kratzsci/ProfessorXY/References/Transmission.md

# Transmission from ESP32 to Arduino
<<<<<<< HEAD
Remaining Characters:
I, J, K, O, Q, V, W, Y, Zero (0)

| **Character** | **Controller Command** |
| :---: | :---: |
| **Menu buttons** |
| `A` | Start |
| `B` | Select |
| `Z` | PS |
| **Shape buttons** |
| `T` | Triangle |
| `X` | Cross |
| `S` | Square |
| `C` | Circle |
| **Directional buttons** |
| `L` | Left |
| `R` | Right |
| `U` | Up |
| `D` | Down |
| **Bumpers** |
| `E` | Left Bumper |
| `F` | Right Bumper |
| **Triggers** |
| `G` | Left Trigger |
| `H` | Right Trigger |
| **Analog sticks** |
| `1` | Forward |
| `2` | Backward |
| `3` | Right |
| `4` | Left |
| `5` | Forward Left |
| `6` | Forward Right |
| `7` | Backward Left |
| `8` | Backward Right |

# Robot commands

| **Character** | **Robot Command** | **Button** |
| :---: | :---: | :---: |
| **Mode** |
| `A` | Limb mode | Start |
| `B` | Simple drive mode | Select |
| `Z` | Demo mode | PS |
| **Head** |
| `U` | Head Up | Up |
| `D` | Head Down | Down |
| **Neck** |
| `L` | Neck Left | Left |
| `R` | Neck Right | Right |
| **Shape buttons** |
| `T` | Left elbow up | Triangle |
| `X` | Left elbow down | Cross |
| `S` | Right elbow up | Square |
| `C` | Right elbow down | Circle |
| **Bumper/Trigger** |
| `E` | Left shoulder up | Left Bumper |
| `F` | Left shoulder down | Right Bumper |
| `G` | Right shoulder up | Left Trigger |
| `H` | Right shoulder down | Right Trigger |
| **Analog sticks** |
| `1` | Forward |
| `2` | Backward |
| `3` | Right |
| `4` | Left |
| `5` | Forward Left |
| `6` | Forward Right |
| `7` | Backward Left |
| `8` | Backward Right |
=======

# Robot commands
| **Buttons** | **Robot Command** | **Character transmitted** |
| :---: | :---: | :---: |
| ----- | ----- | ------ |
| **UNBOUND** | ----- | ----- |
| Start | UNBOUND | `A` |
| Select | UNBOUND | `B` |
| PS | UNBOUND | `Z` |
| Touch Pad | UNBOUND | `Y` |
| ----- | ----- | ------ |
| **Directional Buttons** | ----- | ----- |
| Up | Head up | `U` |
| Left | Neck left | `L` |
| Right | Neck right | `R` |
| Down | Head down | `D` |
| ----- | ----- | ------ |
| **Shape buttons** | ----- | ----- |
| Triangle | Left elbow up | `T` |
| Square | Right elbow up | `S` |
| Circle | Left elbow down | `C` |
| Cross | Right elbow down | `X` |
| ----- | ----- | ------ |
| **Bumper/Trigger** | ----- | ----- |
| Left Bumper | Left shoulder up | `E` |
| Left Trigger | Left shoulder down | `F` |
| Right Bumper | Right shoulder up | `G` |
| Right Trigger | Right shoulder down | `H` |
| ----- | ----- | ------ |
| **Stop all** | ----- | ----- |
| Left Analog sticks center | Stop all | `0` |
| ----- | ----- | ------ |
| **Left Analog sticks** | ----- | ----- |
| ----- | Forward | `1` |
| ----- | Backward | `2` |
| ----- | Right | `3` |
| ----- | Left | `4` |
| ----- | ----- | ------ |
| **Stop all** | ----- | ----- |
| Left Analog sticks center | Stop all | `0` |
>>>>>>> main
