kratzsci/ProfessorXY/Master_s Project Presentation - Philipp _ Johnathan.pptx

## Professor X~~&Y~~ re-work

Philipp Kratsch & Johnathan Hager

## Objective

- Re-work humanoid robot~~s~~
  - Previously worked on by other graduate students
- Two 12V car batteries replace with one 12v
- Robot motors two 24V replace with 12v, if battery change
- Bundle and Clean up wiring

## Objective

- Document the re-design
  - Documentation in progress
- Tighten mechanical parts
- Addition of other work
  - Other work was a complete mess
  - Spent several days trying to sort through

## Problems

- Previous problems we found with the parts
  - One of the arduino megas
  - Four Pololu motor control boards (For the actuators)
  - Roboclaw board (Driving motor control boards)
  - LEDs eyes
  - Servo eyebrows

## Problems

- Previous problems we found with the design
  - Overly complex
  - Nothing seemed to be working together, if at all

## Re-design

- Battery
  - Two 12v to One 12v car battery
- Motors
  - Changed from 24v to 12v
- Charging
  - Extension cord

## Re-design

- Physical switch to control
  - On, Off, and charging mode
- Tighten mechanical parts
  - Straighten up the body
  - Fixed misaligned wheels
  - Checked every joint

## Re-design

- Bundle all wires
  - Removed all previous wiring (it was a mess)
  - Rewired everything for a cleaner look
- Bluetooth control
  - Old usb dongle and hat (Worked intermittently)
  - New ESP32

## Components

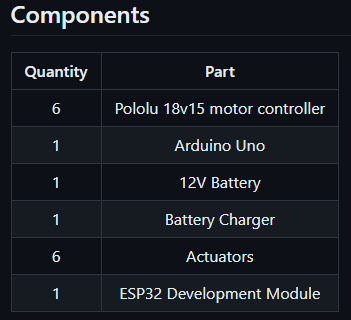
[picture p2: figure]

## Wiring Diagram

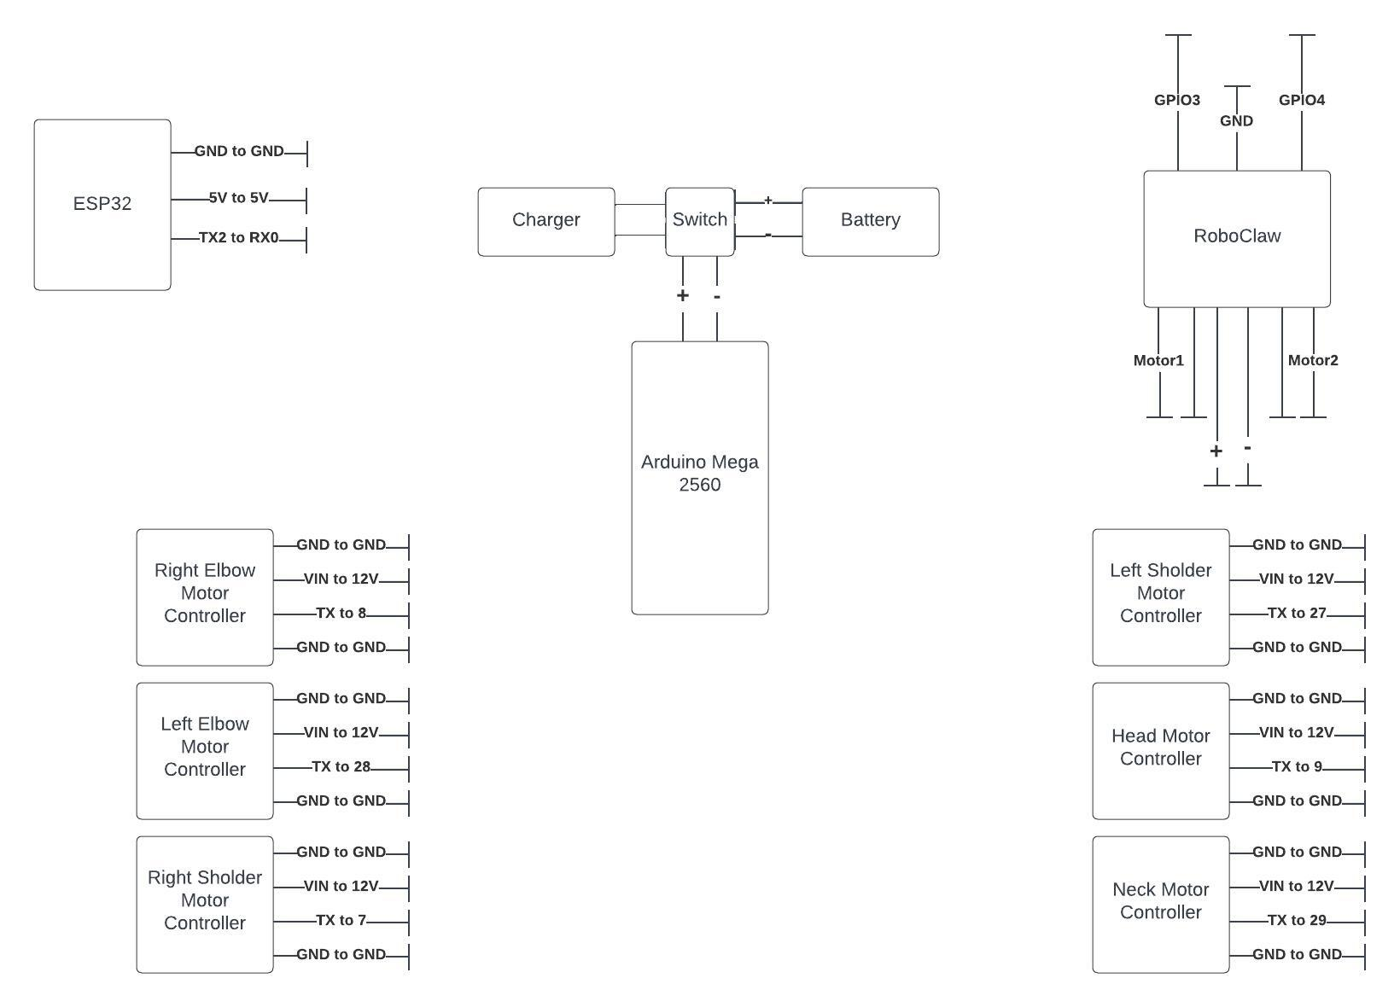
[picture p3: figure]

## ESP32 - Controller

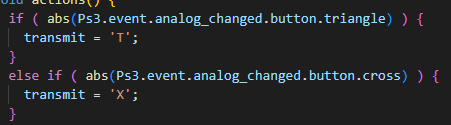
[picture p4: figure]
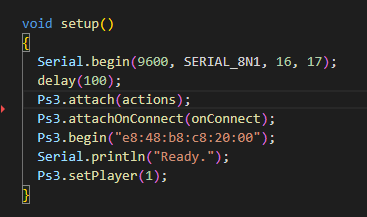
[picture p5: figure]

## Arduino - Robot

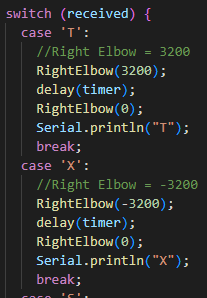
[picture p6: figure]
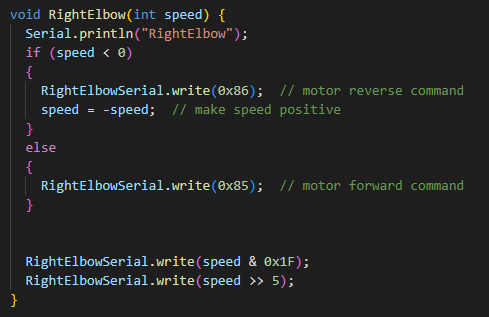
[picture p7: figure]

## Demo

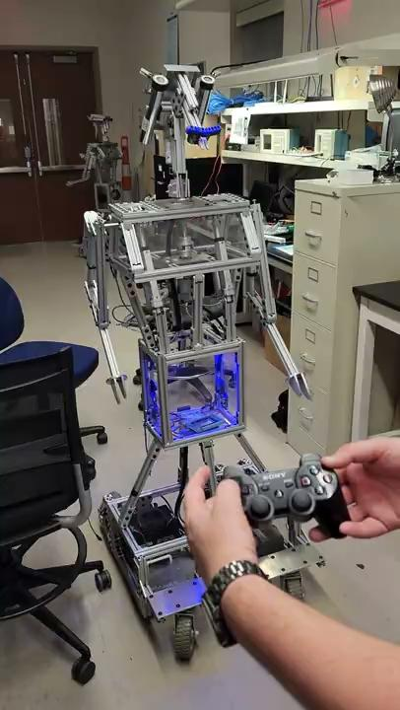
[picture p8: figure]

- Video
- Live

## Recommend future work

- Mechanically reworked
  - Less of a rigid design
  - Remove excess weight
- Additions
  - New LEDs for the eyes
  - New servos for the eyebrows
  - Speakers
  - Custom PCB for wiring and components

## References

- Listed in github repo
  - https://github.com/kratzsci/ProfessorXY/blob/main/README.md
