kratzsci/ProfessorXY/(commit log)

2022-09-25 Actuators
    Functions for the five actuators to move head and arms
2022-09-26 Actuator setup
    Finished all setup steps for the actuators
2023-03-26 Update
    Adding code for ESP32, driving, and other components
2023-04-12 UART
    Establish UART communication between Arduino and ESP32
2023-04-23 Serial Control
    Read PS3 controller and transmit serial to Arduino
2023-04-26 Final
    Movement and controls working for buttons
2023-05-05 Final Code
    Final code for the ESP32 and the Arduino
